seanchiaramonte/bldc-motor-controller/docs/schematic/bldc_motor_controller_schematic.pdf

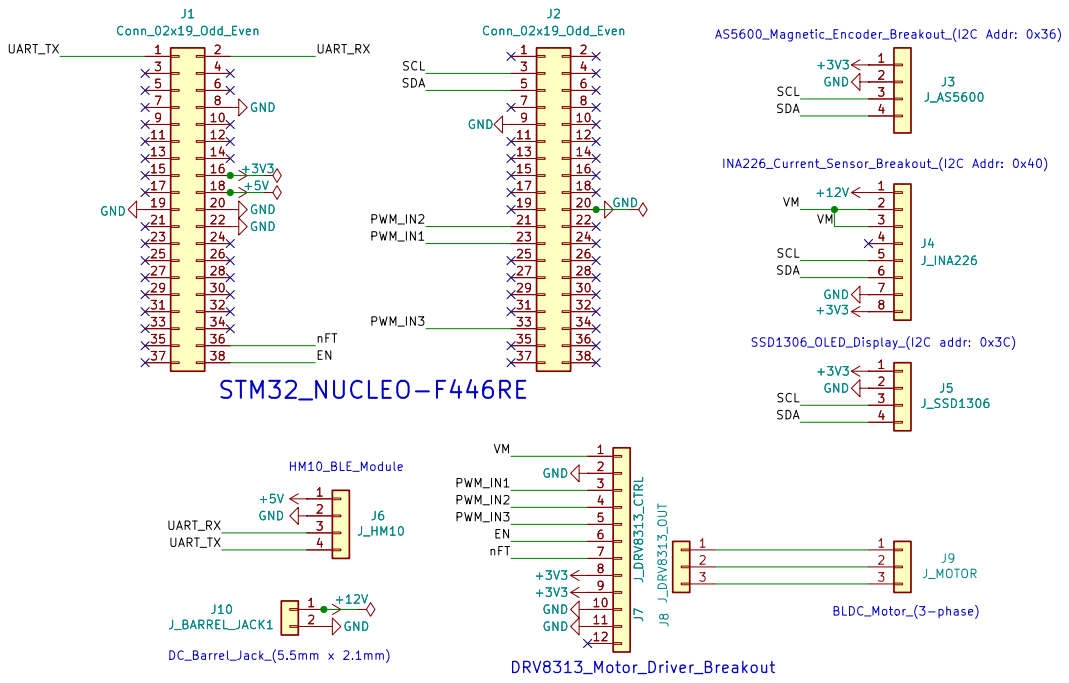
[picture p1: page 1]

Sean Chiaramonte
Sheet: /
File: bldc_motor_controller_schematic.kicad_sch
Title: BLDC Motor Controller

Size: A4 | Rev: v1.0
KiCad E.D.A. 10.0.3 | Id: 1/1
