seanchiaramonte/bldc-motor-controller/hardware/bldc_motor_controller_schematic.kicad_pcb

## KiCad design hardware/bldc_motor_controller_schematic.kicad_pcb (2026-10-25)

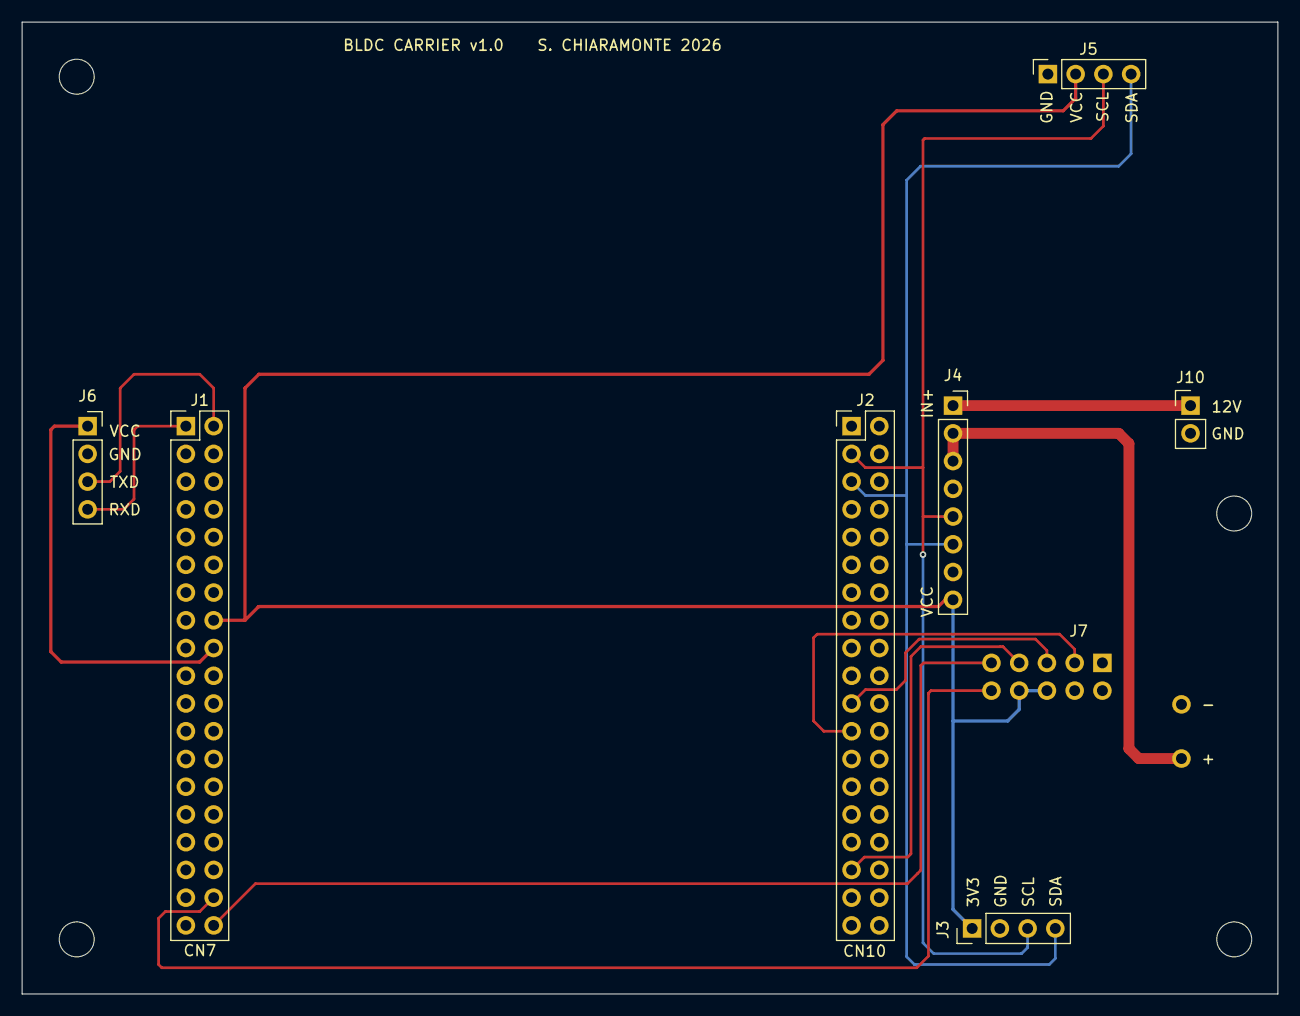
[picture p2: board bldc_motor_controller_schematic.kicad_pcb from above]

Board: 2 copper layers, 115.0 x 89.0 mm, 12 parts (0 on the bottom side), 14 nets.

Parts:
H1, H2, H3, H4: MountingHole_3.2mm_M3
J1, J2: Conn_02x19_Odd_Even; PinHeader_2x19_P2.54mm_Vertical
J3: J_AS5600; PinHeader_1x04_P2.54mm_Vertical
J4: J_INA226; PinSocket_1x08_P2.54mm_Vertical
J5: J_SSD1306; PinSocket_1x04_P2.54mm_Vertical
J6: J_HM10; PinSocket_1x04_P2.54mm_Vertical
J7: J_DRV8313_CTRL; SimpleFOC_Mini_v1
J10: J_BARREL_JACK1; PinHeader_1x02_P2.54mm_Vertical

Connections:
+3V3: J1.16 (3V3), J3.1 (VCC), J4.8 (VCC), J5.2 (VCC), J7.8 (nSP), J7.9 (nRT)
+5V: J1.18 (5V), J6.1 (VCC)
+12V: J4.1 (IN+), J10.1 (+)
/EN: J1.38 (PC0), J7.6 (EN)
/PWM_IN1: J2.23 (PA8), J7.3 (IN1)
/PWM_IN2: J2.21 (PA9), J7.4 (IN2)
/PWM_IN3: J2.33 (PA10), J7.5 (IN3)
/SCL: J2.3 (PB8), J3.3 (SCL), J4.5 (SCL), J5.3 (SCL)
/SDA: J2.5 (PB9), J3.4 (SDA), J4.6 (SDA), J5.4 (SDA)
/UART_RX: J1.2 (PC11), J6.3 (TXD)
/UART_TX: J1.1 (PC10), J6.4 (RXD)
/VM: J4.2 (IN-), J4.3 (VBS), J7.1 (+)
/nFT: J1.36 (PC1), J7.7 (nFT)
GND: J1.8 (GND), J1.19 (GND), J1.20 (GND), J1.22 (GND), J2.9 (GND), J2.20 (GND), J3.2 (GND), J4.7 (GND), J5.1 (GND), J6.2 (GND), J7.2 (-), J7.10 (GND), J7.11 (GND), J10.2 (-)
