seanchiaramonte/bldc-motor-controller/docs/schematic/bldc_motor_controller_schematic.kicad_sch

## KiCad design docs/schematic/bldc_motor_controller_schematic.kicad_sch (2026-09-23)

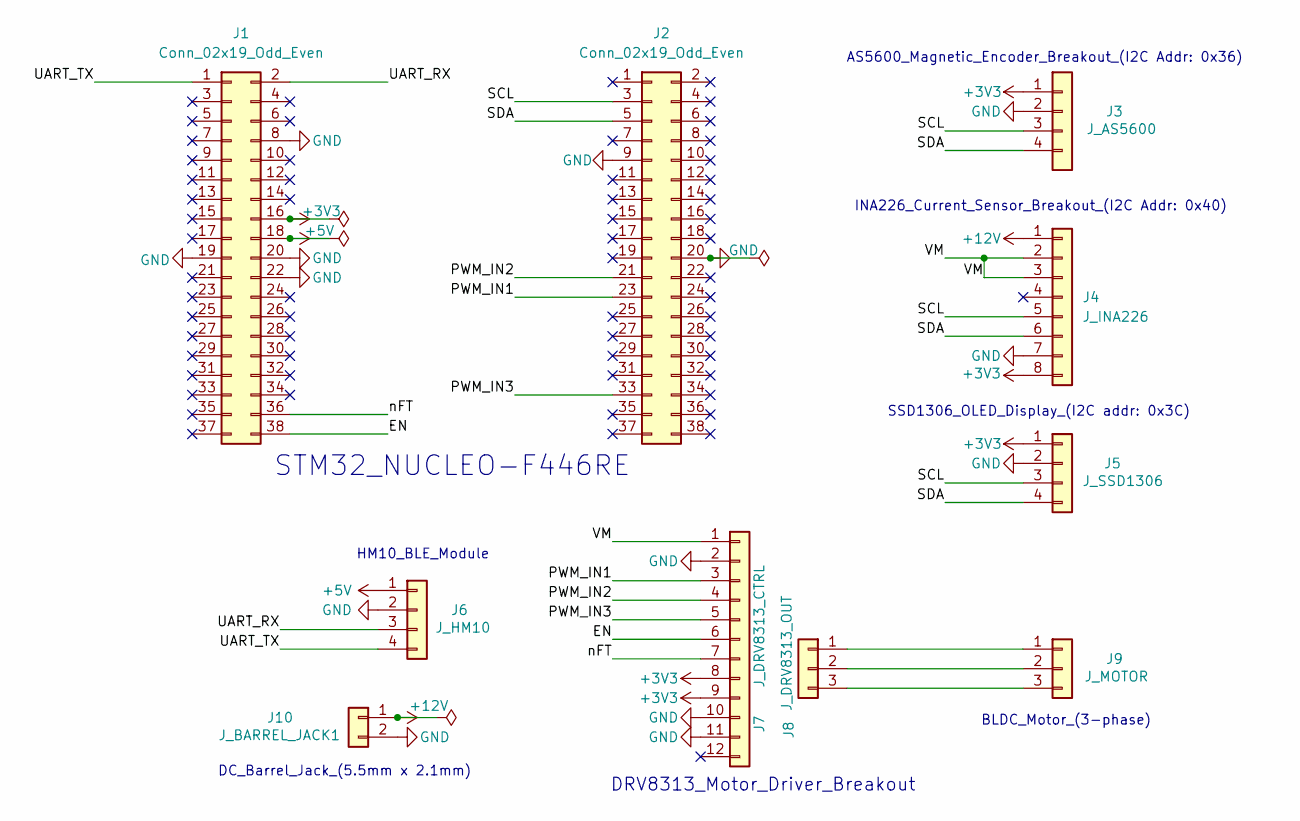
[picture p3: schematic bldc_motor_controller_schematic.kicad_sch]

Parts:
J1, J2: Conn_02x19_Odd_Even
J3: J_AS5600
J4: J_INA226
J5: J_SSD1306
J6: J_HM10
J7: J_DRV8313_CTRL
J8: J_DRV8313_OUT
J9: J_MOTOR
J10: J_BARREL_JACK1

Connections:
+3V3: J1.16 (3V3), J3.1 (VCC), J4.8 (VCC), J5.1 (VCC), J7.8 (nSP), J7.9 (nRT)
+5V: J1.18 (5V), J6.1 (VCC)
+12V: J4.1 (IN+), J10.1 (+)
EN: J1.38 (PC0), J7.6 (EN)
GND: J1.8 (GND), J1.19 (GND), J1.20 (GND), J1.22 (GND), J2.9 (GND), J2.20 (GND), J3.2 (GND), J4.7 (GND), J5.2 (GND), J6.2 (GND), J7.2 (-), J7.10 (GND), J7.11 (GND), J10.2 (-)
unnamed: J8.1 (M1), J9.1 (PHA)
unnamed: J8.2 (M2), J9.2 (PHB)
unnamed: J8.3 (M3), J9.3 (PHC)
PWM_IN1: J2.23 (PA8), J7.3 (IN1)
PWM_IN2: J2.21 (PA9), J7.4 (IN2)
PWM_IN3: J2.33 (PA10), J7.5 (IN3)
SCL: J2.3 (PB8), J3.3 (SCL), J4.5 (SCL), J5.3 (SCL)
SDA: J2.5 (PB9), J3.4 (SDA), J4.6 (SDA), J5.4 (SDA)
UART_RX: J1.2 (PC11), J6.3 (TXD)
UART_TX: J1.1 (PC10), J6.4 (RXD)
VM: J4.2 (IN-), J4.3 (VBS), J7.1 (+)
nFT: J1.36 (PC1), J7.7 (nFT)

Notes on the sheet:
AS5600_Magnetic_Encoder_Breakout_(I2C Addr: 0x36)
INA226_Current_Sensor_Breakout_(I2C Addr: 0x40)
HM10_BLE_Module
DC_Barrel_Jack_(5.5mm x 2.1mm)
STM32_NUCLEO-F446RE
BLDC_Motor_(3-phase)
SSD1306_OLED_Display_(I2C addr: 0x3C)
DRV8313_Motor_Driver_Breakout
