seanchiaramonte/bldc-motor-controller/Core/Src/bluetooth.c

#include "bluetooth.h"

static volatile char bluetoothBuffer[64]; // Buffer size is well above max amount of characters that will likely be sent (10-15)
static volatile uint8_t bluetoothIndex = 0; 
static volatile char commandBuffer[64]; // Completed line gets copied here once terminator arrives (ex. RPM:500)
static uint8_t byteBuffer; // Buffer of one byte, single bytes are written to this buffer as they are received from the Python app via bluetooth
static volatile uint8_t commandReady = 0; 


HAL_StatusTypeDef Bluetooth_Initialize(void)
{
    HAL_StatusTypeDef status = HAL_UART_Receive_IT(&huart3, &byteBuffer, 1); // Received byte goes into the byteBuffer variable

    if (status != HAL_OK) {
        printf("Bluetooth Initialization Failure:%d\r\n", status);
    } else {
        printf("Bluetooth Ready\r\n");
    }

    return status;
}

/** 
 * @brief Receives a byte from an interrupt over USART3.
 * 
 * @details 
 * Checks that the interrupt came from USART3, not from USART2. Checks if a received byte is a terminator; if it is, the line
 * is terminated, copied into commandBuffer, and commandReady is set to 1. If it isn't and there is still space 
 * in the buffer, the byte is added to the buffer. The interrupt is re-armed for the next byte.
 * 
 * @param huart Pointer to the UART handle that triggered the interrupt
*/
void HAL_UART_RxCpltCallback(UART_HandleTypeDef *huart)
{
    if (huart->Instance != USART3) { // Ensures this interrupt came from USART3, not from USART2 because HAL_UART_RxCpltCallback() is shared by every UART
        return; 
    }
    if (byteBuffer == '\r' || byteBuffer == '\n') { // If a byte returns cursor to the beginning of the line or creates a newline, this indicates the end of a line
        bluetoothBuffer[bluetoothIndex] = '\0'; // Terminates the line at that index
        memcpy((char*)commandBuffer, (char*)bluetoothBuffer, bluetoothIndex + 1); // Copies the completed line to commandBuffer and counts the terminate byte
        commandReady = 1;
        bluetoothIndex = 0;
    } else if (bluetoothIndex < 63) { 
        bluetoothBuffer[bluetoothIndex] = byteBuffer; // Store the latest byte received over Bluetooth in the bluetoothBuffer at the current index
        bluetoothIndex++;
    }

    HAL_UART_Receive_IT(&huart3, &byteBuffer, 1); // Interrupt re-arming
}

BluetoothCommand_t Bluetooth_Update(float *rpm)
{
    if (commandReady == 0) {
        return Bluetooth_None; // Nothing happens if a line is not ready and complete
    }

    char localBuffer[64]; 
    memcpy(localBuffer, (char*)commandBuffer, 64); // localBuffer created because commandBuffer can be written by HAL_UART_RxCpltCallback while its being read
    commandReady = 0;

    if (strncmp(localBuffer, "RPM:", 4) == 0) { // Compares the first 4 characters of localBuffer against RPM: which should match
        float localRPM = atof(localBuffer + 4); // Pointer to 4 characters into localBuffer where the number starts

        if (localRPM >= 0.0f && localRPM <= 1000.0f) { // 1000 is a placeholder until actual RPM max is measured 
            *rpm = localRPM;
            return Bluetooth_RPM;
        }

    } else if (strcmp(localBuffer, "START") == 0) { // If Python app sends START
        return Bluetooth_Start;

    } else if (strcmp(localBuffer, "STOP") == 0) { // If Python app sends STOP
        return Bluetooth_Stop;
    }
        
    return Bluetooth_None; // Returned if a command is unrecognized or if RPM is out of range
}

HAL_StatusTypeDef Bluetooth_Send(float actualRPM, float targetRPM, float current, uint16_t motorEN, uint16_t systemFault)
{

    char statusBuffer[20]; 
    if (systemFault == 1) { // Motor faulted
        snprintf(statusBuffer, sizeof(statusBuffer), "FAULT");

    } else if (motorEN == 0) { // Motor stopped
        snprintf(statusBuffer, sizeof(statusBuffer), "STOPPED");

    } else { // Motor running (motorEN == 1)
        snprintf(statusBuffer, sizeof(statusBuffer), "RUNNING");
    }

    char sendBuffer[100];
    snprintf(sendBuffer, sizeof(sendBuffer), "A:%.2f,T:%.2f,C:%.2f,S:%s\r\n", actualRPM, targetRPM, current, statusBuffer); 
    HAL_StatusTypeDef status = HAL_UART_Transmit(&huart3, (uint8_t*)sendBuffer, strlen(sendBuffer), 100); // Send the buffer over Bluetooth to be received by the python task

    if (status != HAL_OK) {
        printf("Bluetooth Send Error:%d\r\n", status);
        return status; 
    }

    return HAL_OK;
}
