seanchiaramonte/bldc-motor-controller/(commit log)

2026-07-08 chore: initial project setup with .gitignore, KiCad schematic, and CubeMX-generated files
    [bldc_motor_controller_schematic.kicad_sch]
2026-07-09 feat: verified toolchain with blinking LED flash
2026-07-11 docs: update log.md, document gimbal motor decision, and fix .gitignore path
2026-07-13 Add printf() debugging over UART2
    -Retargeted the _write function stub to send data through UART
    - Added main loop test using HAL_GetTick function
    - Fixed newline error to ensure correct line breaks in debugger
    [main.c]
2026-07-14 docs: add 003 decision for DRV8313 motor driver
    - Add context by explaining the motor requirements and why the DRV8313 was chosen over alternatives
    - Confirm decision to use the DRV8313 breakout board
    - List the positive and negative consequences of this choice, including MOSFET and flexibility trade-offs
2026-07-15 docs: add 004 decision for AS5600 magnetic encoder
    - Add context by explaining the need for external rotor position sensing and why the AS5600 was chosen over traditional Hall sensors
    - Confirm decision to use the AS5600 magnetic encoder breakout with a diametrically magnetized disk
    - List the positive and negative consequences of this choice, including angle resolution and I2C integration
2026-07-15 docs: add 005 decision for INA226 current sensor
    - Add context by explaining why current sensing is important and why the INA226 was chosen over alternatives
    - Confirm the decision to use the INA226 current sensor breakout with the on-board shunt resistor
    - List the positive and negative consequences of this choice, including reduced hardware and firmware complexity
2026-07-15 hw: update KiCad schematic files
    - Remove on-board capacitor, pull-up resistors, and shunt resistor
    - Add necessary pins to DRV8313 and INA226
    - Fix UART to HM10 connections
    - Add additional connections via net labels
    [bldc_motor_controller_schematic.kicad_sch]
2026-07-16 docs: update project log
    - Add 2026-07-14 log entry for hardware decision
    - Add 2026-07-15 log entries for hardware decisions and schematic updates
2026-07-18 feat: reconfigure STM32CubeMX initialization code
    - Configure DRV_EN and DRV_nFT GPIOs
    - Configure I2C1 GPIOs
    - Configure TIM1 channels for PWM
    - Configure USART2 and USART3 GPIOs and settings
    - Configure FreeRTOS settings and add motorStateMutex
2026-07-21 feat: add AS5600 driver
    - Declare AS5600_ReadAngle() function with doxygen documentation
    - Implement AS5600_ReadAngle function, writing the angle to a pointer output parameter
    - Implement status checking to indicate operation success or failure through return values
    [as5600.c, as5600.h]
2026-07-21 feat(encoder): add RPM calculation
    - Declare mechanicalRPM() function with Doxygen documentation
    - Implement mechanicalRPM() function that finds the change in angle and time to calculate RPM
    - Add rollover and divide-by-zero handling
2026-07-22 feat(encoder): add electrical angle and commutation sector index calculations
    - Declare the Encoder_GetElectricalAngle() and Encoder_GetSector() functions with Doxygen documentation
    - Implement Encoder_GetElectricalAngle() and Encoder_GetSector() functions
    - Define POLE_PAIRS as the constant 7
2026-07-22 chore(encoder): rename mechanicalRPM
    - Rename the function mechanicalRPM() to Encoder_GetRPM() to match the other functions
2026-07-22 feat(encoder): add Encoder_Initialize() function
    - Implement Encoder_Initialize() function with Doxygen documentation
    - Change return value for division-by-zero to filteredRPM
    - Define ALPHA constant to use in the low-pass filter
2026-07-22 refactor(encoder): split Encoder_GetRPM into Encoder_Update and individual getters
    - Add the Encoder_Update() function to calculate filteredRPM, electricalAngle, and commutationSector
    - Modify Encoder_GetRPM, Encoder_GetElectricalAngle, and Encoder_GetSector to only return values from the Encoder_Update function and perform no calculations
    - Declare Encoder_Update() function with Doxygen documentation
    - Update Doxygen documentation in encoder.h for altered functions
2026-08-02 feat(pid): add PID module
    - Implement PID_Initialize(), PID_Reset(), and PID_Update() functions
    - Assign variables in speedPID to placeholder values and zero integral/previousRPM
    - Declare struct and functions in pid.h with Doxygen documentation
    - Implement anti-windup clamp on integral, and finalPID clamp
2026-08-05 test(encoder): verify as5600 and encoder modules work with hardware
    - Add temporary debug code in main.c
    - Comment out FreeRTOS block because its functions never return, which means the while (1) loop never gets reached
    - Add as5600.c and encoder.c to the Makefile to compile and link them to firmware
    - Add -u _printf_float to LDFLAGS in the Makefile to allow RPM to be printed as a float (%.1f)
2026-08-05 docs: add 006 decision for a single I2C bus
    - Include context by explaining the differences between using one or multiple I2C peripherals
    - Confirm the decision to make the AS5600, INA226, and SSD1306 share the I2C1 bus on PB8 and PB9
    - List the positive and negative consequences of the decision, including that no external pull-ups are needed and that higher priority tasks need to wait for in-progress transactions
2026-08-06 docs: add 008 decision for HM-10 BLE module
    - Include context by establishing the need for wireless communication and why the HM-10 was chosen over alternatives
    - Confirm the decision to use the HM-10 on USART3 (PC10/PC11) at 9600 baud connected to 5V
    - List the positive and negative consequences of the decision, including convenience and no security mechanism
2026-08-06 docs: add 009 decision for SSD1306 OLED display
    - Include context by establishing the need for a local display and why the SSD1306 was chosen over alternatives
    - Confirm the decision to add the SSD1306 using the shared I2C bus to display important status data
    - List the positive and negative consequences of the decision, including standalone system status and I2C bus traffic issues
2026-08-06 feat(motor): add motor module with Motor_Initialize() function
    - Implement Motor_Initialize() function with Doxygen documentation which starts the PWM outputs, sets compare registers to zero, and writes the EN pin on PC0 to low
    - Add an enum holding HIGH, LOW, and FLOAT constants
    - Add the commutation table as a const 2D array of the commutation_T type
2026-08-07 feat(motor): add Motor_Enable() and Motor_Disable() functions
    - Implement the Motor_Enable() function that writes EN high via the HAL_GPIO_WritePin() function
    - Implement the Motor_Disable() function that writes EN low and zeros the compare registers for all three TIM1 channels
    - Add Doxygen documentation for both functions in motor.h
2026-08-07 feat(motor): add Motor_ApplyCommutation() function
    - Convert the duty cycle percentage into a compare register value
    - Apply PWM to phases marked HIGH and disable PWM for phases marked LOW and FLOAT
    - Add Doxygen documentation for Motor_ApplyCommutation() in motor.h
2026-08-07 feat(motor): add Motor_CheckFault() function
    - Implement Motor_CheckFault(), which reads the nFT pin (PC1) and returns 1 if a fault is detected and 0 otherwise
    - nFT is active-LOW and the STM32's internal pull-up is enabled, so idle reads HIGH and a fault pulls the pin LOW
    - Add Doxygen documentation for Motor_CheckFault() in motor.h
2026-08-10 fix: guard against dt<=0 and correct integral and output bounds
    - Add dt guard in PID_Update that returns 0.0f if dt is non-positive and leaves the integral and derivative untouched
    - Set lower bounds for integralMin and outputMin to 0.0f instead of -100.0f because six-step commutation does not have negative duty cycles
    [pid.c, pid.h]
2026-08-10 chore: add pid.c and motor.c to Makefile
2026-08-11 test(drv8313): verify the motor module PWM output with no motor connected
    - Add temporary debug code in main.c that calls Motor_Initialize(), Motor_Enable(), and Motor_ApplyCommutation(), with a fault check in the main loop
    - Sector 0 at 15% duty cycle measured 1.8V on M1, 0V on M2 and M3
    - Sector 0 at 30% duty cycle measured 3.6V on M1, 0V on M2 and M3
    - Sector 2 at 15% duty cycle measured 1.8V on M2, and 0V on M1 and M3
2026-08-11 fix(motor): remove FLOAT from commutationTable to match hardware
    - Edit the commutation table to include only HIGH and LOW states because the SimpleFOC Mini ties all enable pins to one EN pin and can't disconnect any individually
    - Edit Motor_Enable() and Motor_ApplyCommutation() documentation in motor.h to reflect the changes
    - Add a missing return value to the Motor_CheckFault() function documentation in motor.h
    [motor.c, motor.h]
2026-08-11 chore(main): add detent alignment test to measure encoder offset
    - Force sector to 0 at 10% duty and print the angle that the rotor settles at
    - Measure the settled angle across three tests (1018, 2763, and 430); any can be used as the zero offset in encoder.c
2026-08-11 fix(encoder): add zero offset and relocate previousAngle and previousTick
    - Add offset of 1018 so that electrical zero aligns with commutation vector zero (0 degrees)
    - Implement the offset subtraction into the electrical angle calculation
    - Move previousAngle and previousTick assignments below dt == 0 so an early return leaves both unchanged, letting the next call measure the full interval
    - Update Doxygen documentation in encoder.h to reflect changes
    [encoder.c, encoder.h]
2026-08-12 feat(main): add temporary commutation test with sector lead
    - Apply commutation at 12% duty with a sector lead of 2 (average of 90 electrical degrees) so the magnetic field leads the rotor
    - Print over UART every 200ms instead of every loop iteration to ensure readability and to avoid slowing the commutation loop
    - Check for HAL_OK and disable the motor if a fault is detected from the DRV8313 or due to an I2C read failure
    - Motor spins continuously at ~305 RPM with a smooth sector sequence, confirming the upstream modules work together correctly
    [main.c]
2026-08-12 fix(encoder): use TIM2 microsecond timebase and fix AS5600 read error
    - Regenerate STM32CubeMX initialization code to include TIM2
    - Replace HAL_GetTick with __HAL_TIM_GET_COUNTER calls
    - Replace the divide by zero guard with a minimum sampling window of DT_US_MIN
    - Tune DT_US_MIN with three tests: no minimum gave +/-40 RPM, 500us gave +/- 8 RPM, and 2000us gave +/- 6 RPM
    - Add an I2C1 force reset to prevent 'Angle Read Error: 2'
    - Update encoder documentation to reflect the changes
    [bldc-motor-controller.ioc, encoder.c, encoder.h, main.c]
2026-08-12 feat(main): add pid and close the control loop
    - Replace the fixed duty cycle with PID_Update() output
    - Add dt calculation using __HAL_TIM_GET_COUNTER()
    - Fix the PID_Update() function and add previousOutput to PID_t in pid.h to return the previous output instead of zero when dt is non-positive
    - Set integralMin to -100.0f so the integral can wind down after overshoots
    - Update pid.h documentation to reflect the changes
    [main.c, pid.c, pid.h]
2026-08-13 feat(pid): tune kp and ki gains
    - Test kp at 0.05, 0.1, 0.2, 0.4, and 0.8. kp was tuned until it clearly oscillated around the target RPM (250) which happened at 0.8. This value was then halved to give margin for changes in load
    - Test ki at 0.5 and 0.25. Both of these tests drastically reduced steady-state error but 0.5 overly accumulated the integral, causing large and growing oscillations, thus ki was changed to 0.25, which holds RPM ~+/-3 around target
    - Leave kd at 0 because there is no significant overshoot to correct for
    [pid.c, pid.h]
2026-08-14 feat(ina226): add INA226_Initialize() function
    - Calculate the calibration value using LSB and shunt resistance and set configuration for the INA226
    - Split 16-bit values into two bytes with buffers, pointed to by HAL_I2C_Mem_Write
    - Write calibration and configuration to the INA226 where the ohm's law calculation is done
    - Print status over UART if a write fails instead of returning anything
    [ina226.c, ina226.h]
2026-08-14 feat(ina226): add INA226_ReadCurrent and return status from INA226_Initialize()
    - Read the raw current from the 0x04 register using HAL_I2C_Mem_Read
    - Assemble the raw current value by casting the bytes into a signed 16 bit integer, scaled to milliamps and return as a float output parameter
    - Return HAL_OK if the read operation succeeds and return status otherwise
    - Change the return type of INA226_Initialize to HAL_StatusTypeDef, so status can now be returned instead of printed
2026-08-14 feat(ina226): add INA226_ReadVoltage()
    - Read the raw voltage value on the IN- side of the shunt resistor
    - Assemble the raw voltage value by casting the bytes into an unsigned 16 bit integer, scaled to volts and return as a float output parameter
    - Add Doxygen documentation for the function in ina226.h
    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
2026-08-16 chore(freertos): define four control tasks and regenerate code in cubemx
    - Add motorTask, monitorTask, bluetoothTask, and displayTask
    - Set a 512 word stack size for the motorTask and a 256 word stack size for every other task; these are just guesses and will be checked later with the uxTaskGetStackHighWaterMark() function
    - Add priorities to each task; motorTask at High, monitorTask at AboveNormal, bluetoothTask at Normal, and displayTask at BelowNormal
2026-08-17 feat(freertos): implement the motorTask with mutex integration
    - Move the encoder read, PID update, commutation, and all of the relevant function calls from main.c to the motorTask
    - Add global volatile states for targetRPM, actualRPM, motorEN, and systemFault, guarded by the motorStateMutex and copied into local variables so they operate via a fixed snapshot
    - Disable the motor and skip the motor control part of the function if there is a fault or motorEN is 0
    - Schedule the task with osDelayUntil() in every path instead of osDelay() so scheduling can be controlled directly, eliminating drift
    [main.c]
2026-08-17 feat(freertos): implement the monitor task with mutex integration
    - Read the INA226 every 10 ms and publish the reading globally using the current variable
    - Add the overcurrent threshold and set it to 700 mA, below the max 819 mA current that the INA226 can measure
    - Set the global systemFault variable to 1 and the global motorEN variable to 0 if the current is above the overcurrent threshold, there is a DRV8313 fault, or the INA226_Initialize() call fails
2026-08-18 feat(bluetooth): implement Bluetooth_Initialize() and HAL_UART_RxCpltCallback() functions
    - Arm the interrupt on USART3 at startup
    - Assemble incoming bytes into a line, copy that line to commandBuffer, and set commandReady to one when a terminator is detected
    - Re-arm the interrupt for the next byte because HAL_UART_Receive_IT only arms for a single byte at a time
2026-08-18 feat(bluetooth): implement Bluetooth_Update() function
    - Check the status of commandReady; if false, the function returns; if true, the function continues
    - Copy commandBuffer into a local buffer to prevent read/write conflicts
    - Assign the RPM value to targetRPM using the mutex if the local buffer holds RPM and it's within the RPM range. If it holds START, set motorEN to 1 and systemFault to 0, and if it holds STOP, set motorEN to 0
    [bluetooth.c, bluetooth.h]
2026-08-19 feat(freertos): add and reorganize mutexes
    - Add i2cMutex to protect the I2C1 peripheral from transaction conflicts by regenerating the initialization code in STM32CubeMX
    - Add the i2cMutex to the AS5600 and INA226 functions called within the motor and monitor tasks
    - Rename the default motorStateMutex to sharedDataMutex to accurately reflect its function which is to protect shared variables from read/write conflicts
2026-08-19 chore(display): add afiskon ssd1306 library
    - Add ssd1306.h, ssd1306_conf.h, ssd1306_fonts.h to Core/Inc and ssd1306.c and ssd1306_fonts.c to Core/Src
    - Configure ssd1306_conf.h for STM32F4, I2C via the I2C1 peripheral, and a 128x64 display
    - Enable the 7x10 font because it comfortably fits the information needed to display
    - Add ssd1306.c and ssd1306_fonts.c to Makefile
2026-08-19 feat(display): implement the Display_Initialize() and Display_Update() functions
    - Call ssd1306_Init() to configure the chip's settings
    - Reset the display visually and the display data stored in RAM
    - Write targetRPM/actualRPM on the first line, current in mA on the second line, and status (FAULT, STOPPED, RUNNING) on the third line
    - Display FAULT if systemFault is true, STOPPED if motorEN is false, and RUNNING otherwise
    [display.c, display.h]
2026-08-19 feat(freertos): implement the display task
    - Call the Display_Initialize() function once before the loop and protect it with the i2cMutex
    - Copy all five shared variables into local variables, protected by the sharedDataMutex
    - Call the Display_Update() function every 200ms and protect it with the i2cMutex
2026-09-02 feat(bluetooth): implement the Bluetooth_Send() function
    - Add Bluetooth_Send() to assemble a string holding actualRPM, targetRPM, current, and systemStatus
    - Determine status from the states of motorEN and systemFault, storing that result in the assembled string
    - Call Bluetooth_Send() from the bluetooth task in freertos.c every 100ms because an 80ms message cannot be run every 20ms (how often the task runs)
    - Store shared variables in local variables, protected by the sharedDataMutex and release the mutex before transmitting
    - Add display.c to the Makefile and include display.h in freertos.c and include ssd1306_fonts.h in display.h
2026-09-05 feat(gui): implement the start_async_loop() and scan_and_connect() functions
    - Import asyncio, tkinter, and bleak libraries
    - Declare global variables, including the HM-10's UUID
    - Run the asyncio loop on a background thread and assign it to the global loop variable so it can be reached everywhere in the file
    - Scan for and identify the HM-10
    - Connect to the HM-10, tell it to start sending data, and call the notification handler (added in the next commit) as a callback when data arrives
2026-09-06 feat(gui): implement the ble_notification_handler() function
    - Decode the binary coming from the HM-10 and split it so that RPM, current, and status are separated
    - Split names from values, enter these into a dictionary, and assign values to names
    - Get the values from the dictionary and assign them to variables or assign 0 if the value is missing
    - Update the GUI with the values stored in the variables
2026-09-06 feat(gui): implement send_command() function and all send path functions
    - Write bytes to the HM-10's UUID and add the newline character to signify completion
    - Skip the write if the client and HM-10 are not connected
    - Send START, STOP, or RPM:<value> on the background loop, transferring the command from the GUI thread to the Bluetooth thread
2026-09-06 feat(gui): implement the build_gui() function and program initialization block
    - Create the GUI window with its title and size
    - Create StringVar boxes to hold values for actual RPM, target RPM, current, status, and connection status
    - Add a slider for target RPM that updates while the slider is being moved
    - Add a separate set RPM button so moving the slider doesn't constantly send commands
    - Add the Connect, Start, and Stop buttons
    - Create and start the loop on a daemon thread so the program is terminated when the window is closed
    - Build the GUI window and start running it until the user closes it
2026-09-06 fix(display): hold the i2c mutex per chunk instead of for the whole screen refresh
    - Move the mutex from the display task in freertos.c to ssd1306.c so the mutex is released between chunk writes
    - Update the display in 32-byte chunks so the mutex is not held longer than the motor task's 1ms update rate
2026-09-07 fix(gui): reassemble fragmented Bluetooth notifications
    - Reduce length of the snprintf in bluetooth.c to only necessary characters, reducing transmission time and command response delay
    - Add a receive_buffer global in motor_control_gui.py to hold each fragment because BLE can only transmit 20 bytes at a time
    - Split the buffer at the newline character, assign the first (completed) part to the line variable, and assign the second (non-completed) part back to the buffer to wait for the rest of its line
    [bluetooth.c]
2026-09-07 fix(motor): remove stale RPM values and prevent overcurrent fault on startup
    - Set the motorEN variable to 0 so the motor stays disabled until a start command is received
    - Acquire and release the sharedDataMutex while setting actualRPM to 0 when the motor is stopped
    - Update the time reference for previousPidTick when the motor is stopped so dt is not measured from a stale time value
    - Clamp dutyCycle to 40% when RPM is below 50 to prevent overcurrent fault on startup
2026-09-08 fix(freertos): set motorEN's state directly and remove the stale targetRPM debugging value
    - Write motorEN and systemFault directly if a current read failure occurs, instead of calling Motor_Disable(), which didn't change motorEN or systemFault
    - Remove the targetRPM = 250 value that was used for debugging when the python app was not fully integrated
2026-09-08 fix(freertos): set systemFault after repeated AS5600 read failures and initialize angle
    - Add the readFailures variable which tracks how many consecutive failures occur
    - Set systemFault to 1 when 5 consecutive AS5600 read failures occur to prevent the motor task from never sleeping, since a 1.7ms printf is constantly executing when the task has a 1ms period
    - Initialize the angle variable to 0 to prevent an uninitialized value from being passed to Encoder_Initialize()
2026-09-09 fix(motor): scale the startup clamp with targetRPM and initialize targetRPM
    - Edit the duty cycle clamp to scale with targetRPM, instead of the clamp releasing when RPM exceeded 50
    - Clamp duty cycle to 40% if actualRPM is less than 80% of targetRPM and the duty cycle is already greater than 40%
    - Initialize targetRPM to 0 to show intent (globals automatically initialized by C)
2026-09-23 feat(hardware): convert schematic to carrier pcb layout
    - Replace the five connectors that made up the STM32 with two 2x19 connectors so every physical pin gets a hole on the PCB
    - Re-map the STM32's peripherals and power nets to the new 2x19 connectors and mark unused pins with a no-connect flag
    - Add missing module pins to match physical hardware: ALE on the INA226 and 3V3/GND on the DRV8313
    - Exclude the motor and driver output connectors from the board because the motor phase wires will be soldered directly to the DRV8313
    [bldc_motor_controller_schematic.kicad_sch]
2026-10-24 feat(hardware): assign footprints and complete PCB placement
    - Move the full KiCad project into hardware/ so the schematic, PCB, and custom footprint library are tracked with the firmware
    - Assign footprints to every module, using pin header footprints for the Nucleo since KiCad's 2x19 socket footprint mirrors the pin numbering
    - Swap VCC and GND on the SSD1306 connector to match the physical board's pin order
    - Add a custom SimpleFOC Mini v1 footprint, including pads for its off-grid + and - power pins
    - Add Power (1.0 mm) and Logic (0.5 mm) net classes for the motor supply and logic rails
    - Place the Nucleo connectors from ST's MB1136 mechanical drawing and arrange modules around them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
2026-10-25 feat(hardware): route all nets on the carrier PCB
    - Route the 12 V and VM motor supply path through the INA226 at 1.0 mm
    - Add a GND pour across the bottom layer
    - Route the UART, I2C, 3V3, 5V, PWM, EN, and nFT nets, splitting I2C and 3V3 across both layers to avoid crossings
    - Narrow the Logic net class to 0.3 mm so traces fit between the Morpho header pads
    - Remove a 3V3 track stub so DRC passes with no errors or warnings
2026-10-25 feat(hardware): finalize carrier PCB for fabrication
    - Rotate the SSD1306 connector so the display reads upright, and reroute its 3V3, SCL, and SDA traces
    - Add silkscreen pin labels for the power, encoder, HM-10, OLED, and INA226 connectors
    - Add board name, version, and author to the silkscreen
